dustinandrews/Red-Soul/readme

Robotic Minion Starter Kit (Arduino Compatible)
http://authenticinvention.com/authentic/?post_type=landing_page&p=47

Codename: Red-Soul

License: http://creativecommons.org/licenses/by/3.0/

Eagle files, code and other files for an Arduino compatible platform.
