dustinandrews/Red-Soul/Platform/OpenScad/pj-019.stl

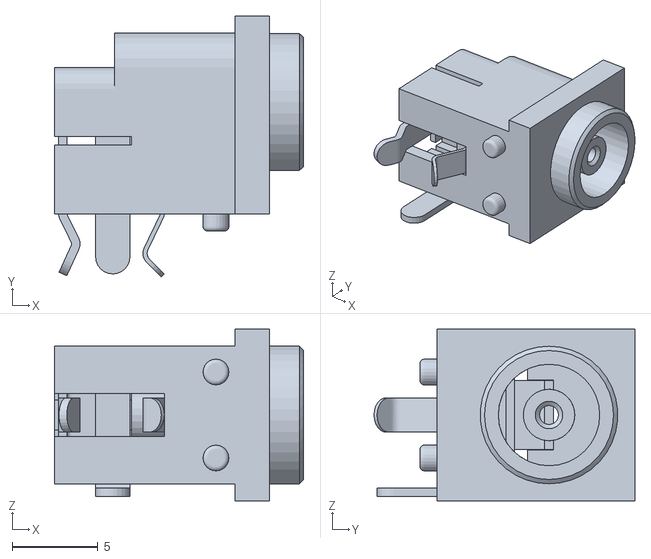
[picture p1: CAD file, 2012-04-17]
Platform/OpenScad/pj-019.stl
14.5 x 15.2 x 10.0
