dustinandrews/Red-Soul/Platform/OpenScad/SurfaceSwitch.stl

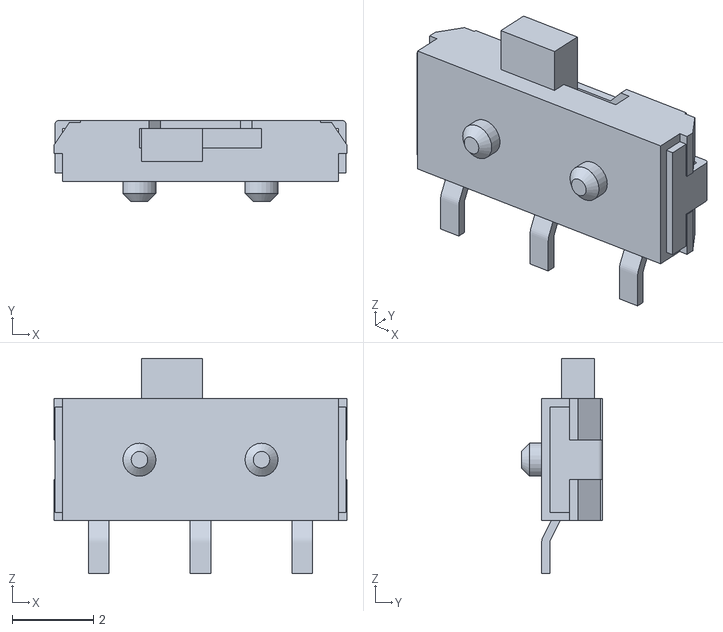
[picture p2: CAD file, 2012-04-17]
Platform/OpenScad/SurfaceSwitch.stl
7.20 x 2.00 x 5.29
