dustinandrews/Red-Soul/Platform/OpenScad/usbJack_B.stl

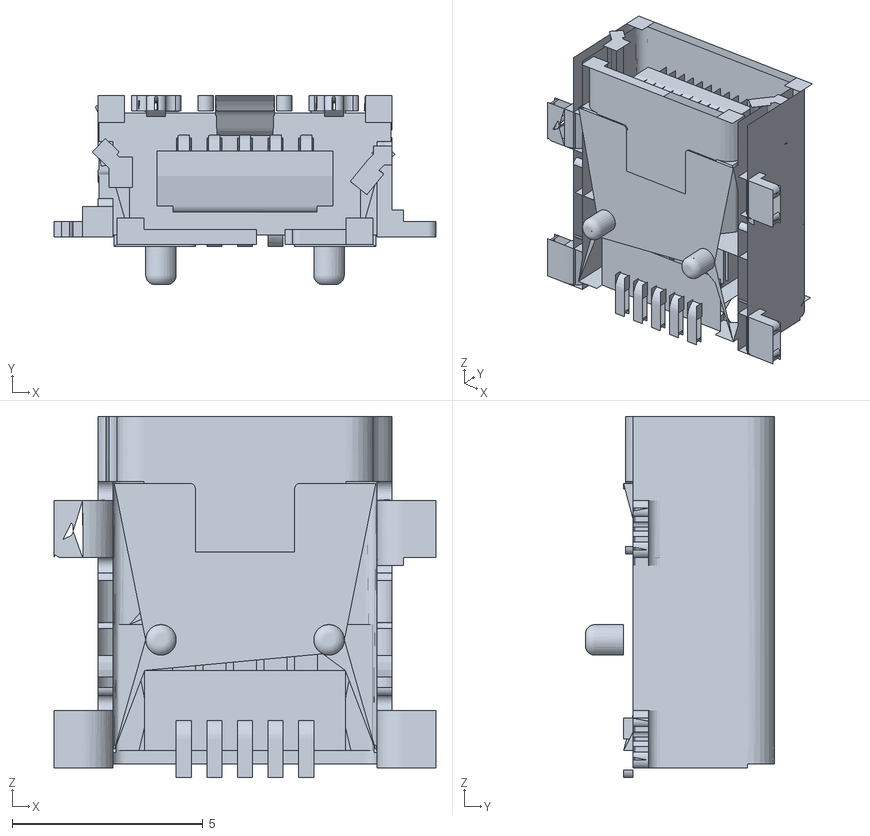
[picture p3: CAD file, 2012-04-17]
Platform/OpenScad/usbJack_B.stl
10.0 x 4.96 x 9.46
