dustinandrews/Red-Soul/Platform/PlatformCB.pdf

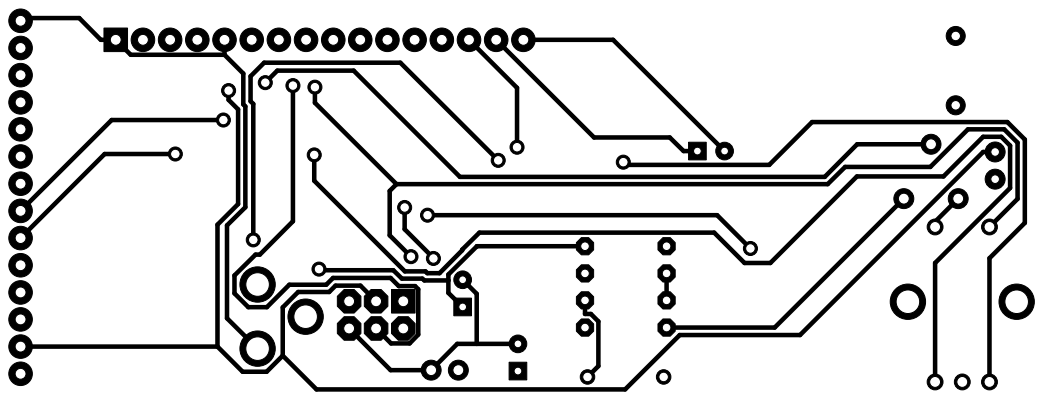
[picture p4: page 1]
