dustinandrews/Red-Soul/Platform/PlatformCT.pdf

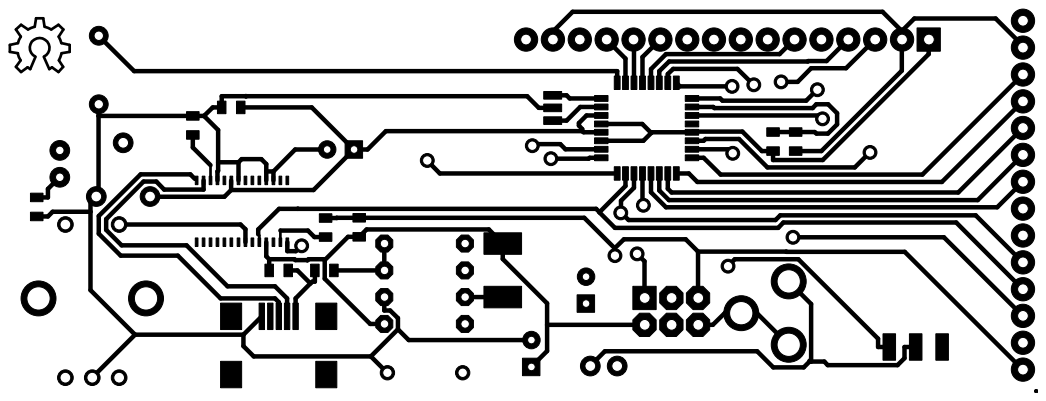
[picture p5: page 1]
