dustinandrews/Red-Soul/(list of files, drawings)

Other design files:
BuckRegulatorBoard/BuckPower.dsn
FTDI/ftdiBreakout.dsn
Platform/Platform.dsn
