dustinandrews/Red-Soul/Platform/Platform.brd

## EAGLE design Platform/Platform.brd (2012-07-20)

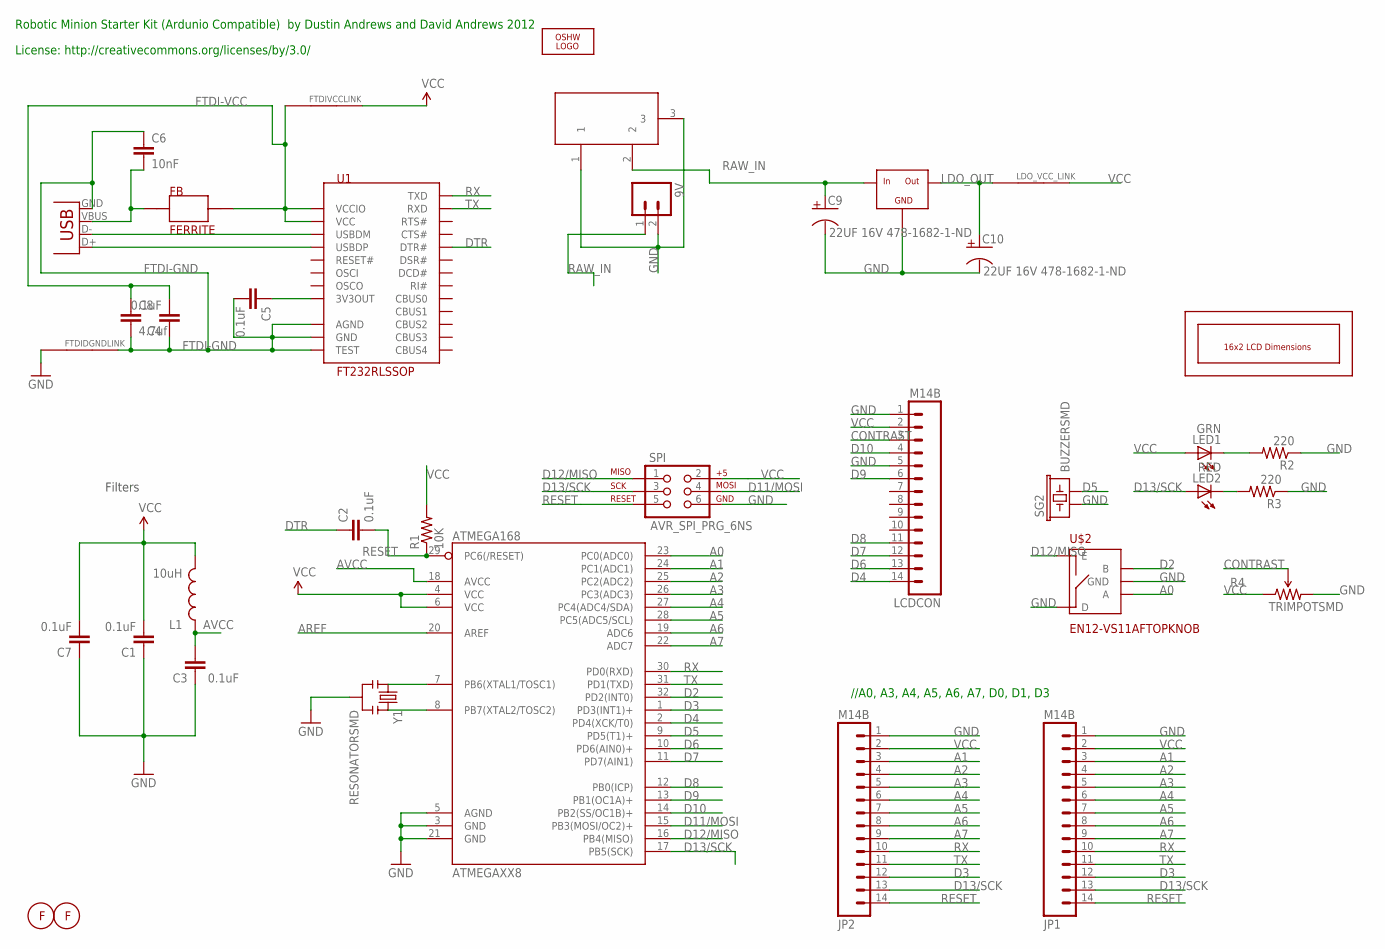
[picture p6: schematic Platform.sch]

Parts:
9V: M02PTH; 1X02
ATMEGAXX8: ATMEGA168; TQFP32-08; DIGIKEY# ATMEGA328-AU
C1, C2, C3, C4, C5, C7: 0.1uF; 0805; DIGIKEY# 478-1395-1-ND
C6: 10nF; C0805
C8: 4.7uf; 0805; DIGIKEY# 445-1369-1-ND
C9, C10: 22UF 16V 478-1682-1-ND; 1210POL; DIGIKEY# 478-1682-1-ND
FB: FERRITE; 0805; DIGIKEY# 240-2399-1-ND
FM1, FM2: FIDUCIAL1MM; 1MMCIRCLE
FTDIDGNDLINK: LINK; ISOLATOR
FTDIVCCLINK: LINK; ISOLATOR
J1: DC21MMX; DC-21MM
JP1, JP2: M14B; 1X14B
L1: 10uH; 0805; DIGIKEY# 587-2048-1-ND
LCDCON: M14B; 1X14B; DIGIKEY# 67-1781-ND
LDO_VCC_LINK: LINK; ISOLATOR
LED1: GRN; LED-0805; DIGIKEY# 754-1131-1-ND
LED2: RED; LED-0805; DIGIKEY# 475-1278-1-ND
LOGO1: OSHW_LOGO_10MILX0750-NT; OSHW_10X750_NOTEXT
R1: 10K; 0805; DIGIKEY# RHM10.0KAECT-ND
R2, R3: 220; 0805; DIGIKEY# RHM220AECT-ND
R4: TRIMPOTSMD; TRIMPOT-3MM; DIGIKEY# 490-4611-1-ND
SG2: BUZZERSMD; BUZZER-CMT1603; DIGIKEY# 668-1110-1-ND
SPI: AVR_SPI_PRG_6NS; 2X3-NS
U1: FT232RLSSOP; SSOP28; DIGIKEY# 768-1007-1-ND
U$1: IFX25001TC; TO263-3; DIGIKEY# IFX25001TC V50INCT-ND
U$2: EN12-VS11AFTOPKNOB; 12MM_ROTATY_TOP; DIGIKEY# 987-1194-ND
U$3: LCM-S01602DTR; LCD16X2
X1: USBSMD; USB-MINIB; DIGIKEY# ED2992CT-ND
Y1: RESONATORSMD; RESONATOR-SMD; DIGIKEY# 490-1198-1-ND

Connections:
3V3OUT: C5.1, U1.17 (3V3OUT)
A0: ATMEGAXX8.23 (PC0(ADC0)), U$2.A
A1: ATMEGAXX8.24 (PC1(ADC1)), JP1.3, JP2.3
A2: ATMEGAXX8.25 (PC2(ADC2)), JP1.4, JP2.4
A3: ATMEGAXX8.26 (PC3(ADC3)), JP1.5, JP2.5
A4: ATMEGAXX8.27 (PC4(ADC4/SDA)), JP1.6, JP2.6
A5: ATMEGAXX8.28 (PC5(ADC5/SCL)), JP1.7, JP2.7
A6: ATMEGAXX8.19 (ADC6), JP1.8, JP2.8
A7: ATMEGAXX8.22 (ADC7), JP1.9, JP2.9
AREF: ATMEGAXX8.20 (AREF)
AVCC: ATMEGAXX8.18 (AVCC), C3.2, L1.1
CONTRAST: LCDCON.3, R4.2 (WIPER)
D2: ATMEGAXX8.32 (PD2(INT0)), U$2.B
D3: ATMEGAXX8.1 (PD3(INT1)+), JP1.12, JP2.12
D4: ATMEGAXX8.2 (PD4(XCK/T0)), LCDCON.14
D5: ATMEGAXX8.9 (PD5(T1)+), SG2.P$2 (2)
D6: ATMEGAXX8.10 (PD6(AIN0)+), LCDCON.13
D7: ATMEGAXX8.11 (PD7(AIN1)), LCDCON.12
D8: ATMEGAXX8.12 (PB0(ICP)), LCDCON.11
D9: ATMEGAXX8.13 (PB1(OC1A)+), LCDCON.6
D10: ATMEGAXX8.14 (PB2(SS/OC1B)+), LCDCON.4
D11/MOSI: ATMEGAXX8.15 (PB3(MOSI/OC2)+), SPI.4
D12/MISO: ATMEGAXX8.16 (PB4(MISO)), SPI.1, U$2.E
D13/SCK: ATMEGAXX8.17 (PB5(SCK)), JP1.13, JP2.13, LED2.A, SPI.3
D+: U1.15 (USBDP), X1.D+
D-: U1.16 (USBDM), X1.D-
DTR: C2.1, U1.2 (DTR#)
FTDI-GND: C4.1, C5.2, C6.1, C8.2, FTDIDGNDLINK.P$2, U1.7 (GND), U1.18 (GND), U1.21 (GND), U1.25 (AGND), U1.26 (TEST), X1.GND
FTDI-VCC: C4.2, C8.1, FB.2, FTDIVCCLINK.P$1, U1.4 (VCCIO), U1.20 (VCC)
GND: 9V.2, ATMEGAXX8.3 (GND), ATMEGAXX8.5 (AGND), ATMEGAXX8.21 (GND), C1.1, C3.1, C7.1, C9.2 (-), C10.2 (-), FTDIDGNDLINK.P$1, J1.1, J1.3, JP1.1, JP2.1, LCDCON.1, LCDCON.5, R2.1, R3.1, R4.3 (CW), SG2.P$1 (1), SPI.6, U$1.2 (GND), U$1.TAB (GND), U$2.C (GND), U$2.D, Y1.2
LDO_OUT: C10.1 (+), LDO_VCC_LINK.P$1, U$1.3 (OUT)
unnamed: LED2.C, R3.2
unnamed: LED1.C, R2.2
RAW_IN: 9V.1, C9.1 (+), J1.2, U$1.1 (IN)
RESET: ATMEGAXX8.29 (PC6(/RESET)), C2.2, JP1.14, JP2.14, R1.1, SPI.5
RX: ATMEGAXX8.30 (PD0(RXD)), JP1.10, JP2.10, U1.1 (TXD)
TX: ATMEGAXX8.31 (PD1(TXD)), JP1.11, JP2.11, U1.5 (RXD)
VBUS: C6.2, FB.1, X1.VBUS
VCC: ATMEGAXX8.4 (VCC), ATMEGAXX8.6 (VCC), C1.2, C7.2, FTDIVCCLINK.P$2, JP1.2, JP2.2, L1.2, LCDCON.2, LDO_VCC_LINK.P$2, LED1.A, R1.2, R4.1 (CCW), SPI.2
XTAL1: ATMEGAXX8.7 (PB6(XTAL1/TOSC1)), Y1.1
XTAL2: ATMEGAXX8.8 (PB7(XTAL2/TOSC2)), Y1.3

Notes on the sheet:
Filters
//A0, A3, A4, A5, A6, A7, D0, D1, D3
Robotic Minion Starter Kit (Ardunio Compatible) by Dustin Andrews and David Andrews 2012
License: http://creativecommons.org/licenses/by/3.0/

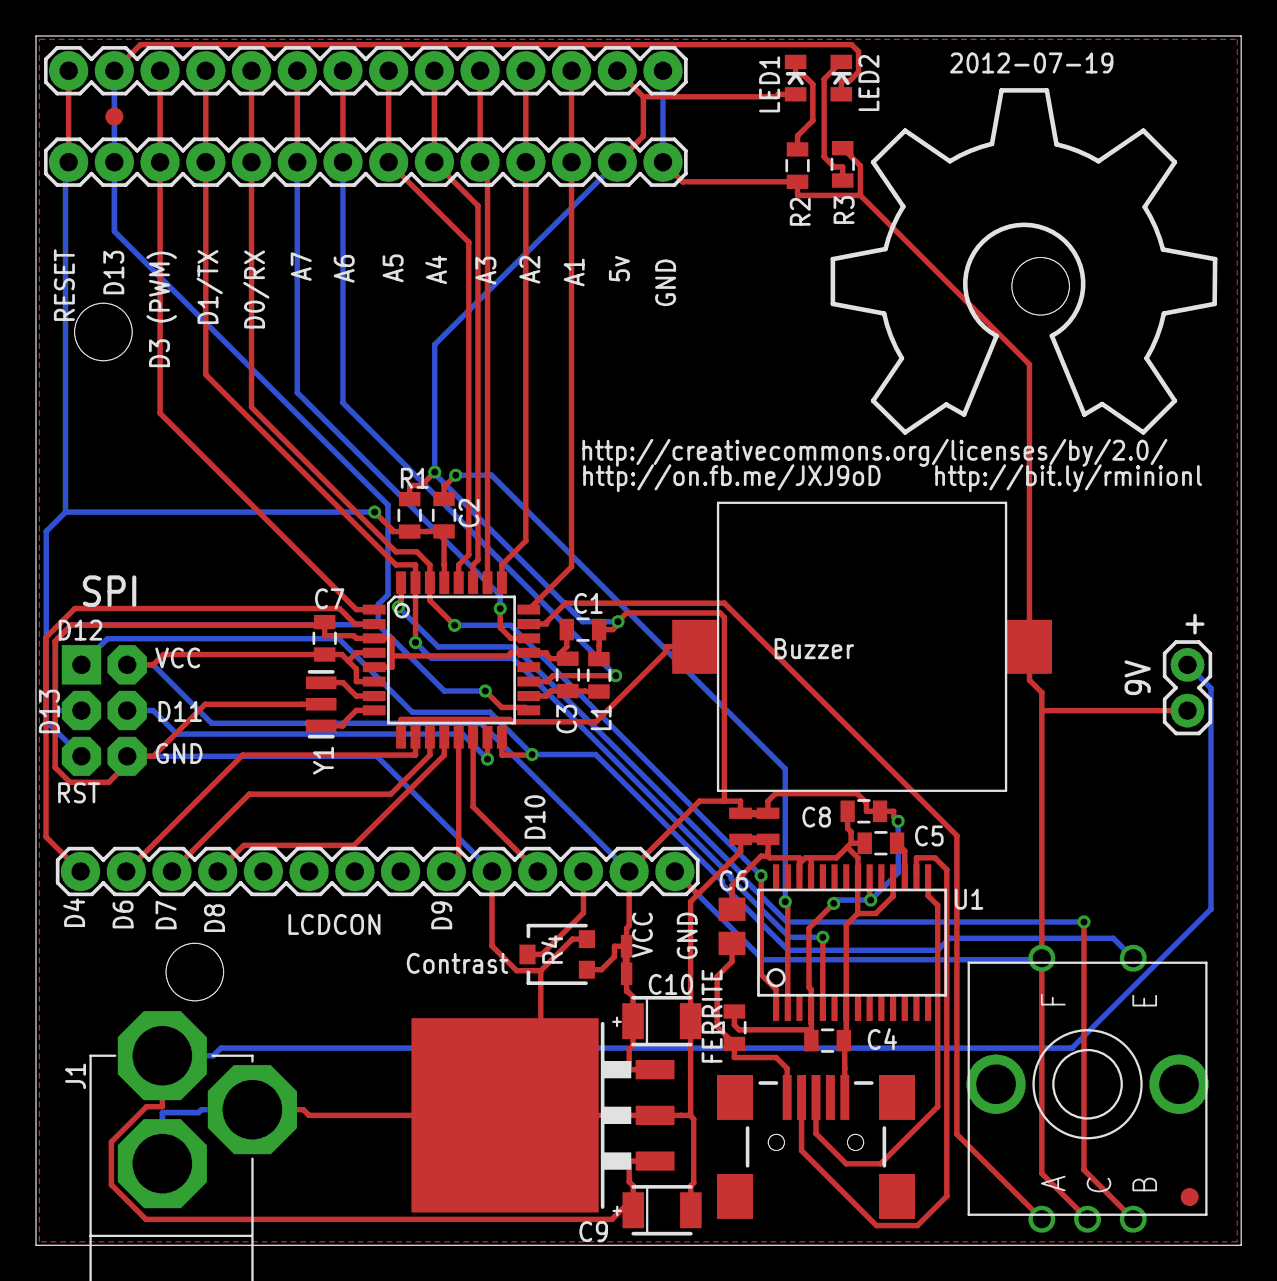
[picture p7: board Platform.brd from above]

Board: 2 copper layers, 67.0 x 67.2 mm, 38 parts (0 on the bottom side), 40 nets.
