dustinandrews/Red-Soul/BuckRegulatorBoard/BuckPower.brd

## EAGLE design BuckRegulatorBoard/BuckPower.brd (2012-04-22)

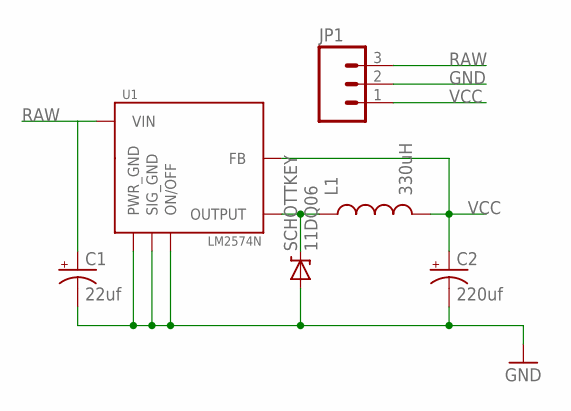
[picture p8: schematic BuckPower.sch]

Parts:
C1: 22uf; CPOL-RADIAL-100UF-25V
C2: 220uf; CPOL-RADIAL-100UF-25V
JP1: M031X03_NO_SILK; 1X03_NO_SILK
L1: 330uH; INDUCTOR-1206
SCHOTTKEY: 11DQ06; DIODE-ZENER
U1: LM2574N; 8DILL

Connections:
GND: C1.2 (-), C2.2 (-), JP1.2, SCHOTTKEY.P$2 (A), U1.2 (SIG_GND), U1.3 (ON/OFF), U1.4 (PWR_GND)
unnamed: L1.P$1 (1), SCHOTTKEY.P$1 (C), U1.7 (OUTPUT)
RAW: C1.1 (+), JP1.3, U1.5 (VIN)
VCC: C2.1 (+), JP1.1, L1.P$2 (2), U1.1 (FB)

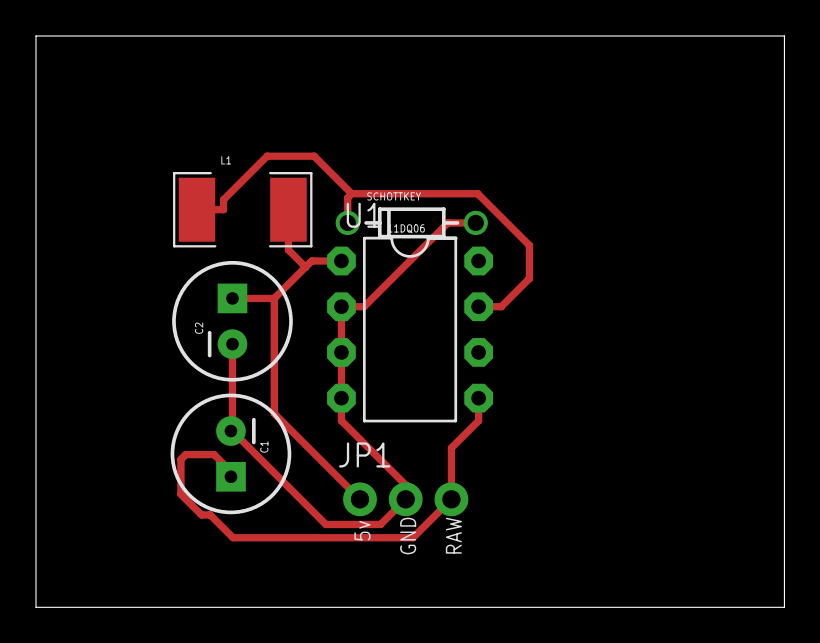
[picture p9: board BuckPower.brd from above]

Board: 2 copper layers, 41.6 x 31.7 mm, 6 parts (0 on the bottom side), 4 nets.
