dustinandrews/Red-Soul/FTDI/ftdiBreakout.brd

## EAGLE design FTDI/ftdiBreakout.brd (2012-04-22)

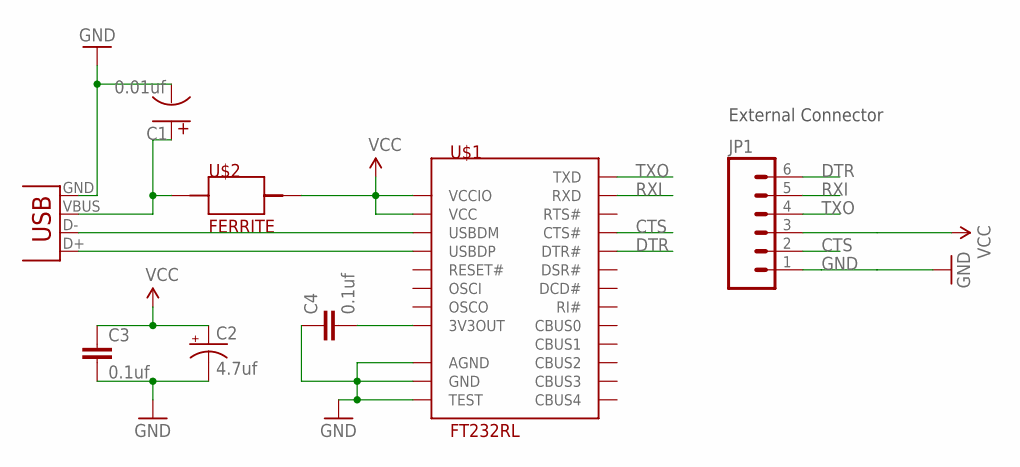
[picture p10: schematic ftdiBreakout.sch]

Parts:
C1: 0.01uf; 0805POL
C2: 4.7uf; CPOL-RADIAL-100UF-25V
C3, C4: 0.1uf; 0805
JP1: M06SIP; 1X06
U$1: FT232RL; TSSOP28
U$2: FERRITE; 0805
X1: USBSMD; USB-MINIB

Connections:
CTS: JP1.2, U$1.11 (CTS#)
DTR: JP1.6, U$1.2 (DTR#)
GND: C1.-, C2.2 (-), C3.2, C4.1, JP1.1, U$1.7 (GND), U$1.18 (GND), U$1.21 (GND), U$1.25 (AGND), U$1.26 (TEST), X1.GND
unnamed: C1.+, U$2.1, X1.VBUS
unnamed: U$1.16 (USBDM), X1.D-
unnamed: U$1.15 (USBDP), X1.D+
unnamed: C4.2, U$1.17 (3V3OUT)
RXI: JP1.5, U$1.5 (RXD)
TXO: JP1.4, U$1.1 (TXD)
VCC: C2.1 (+), C3.1, JP1.3, U$1.4 (VCCIO), U$1.20 (VCC), U$2.2

Notes on the sheet:
External Connector

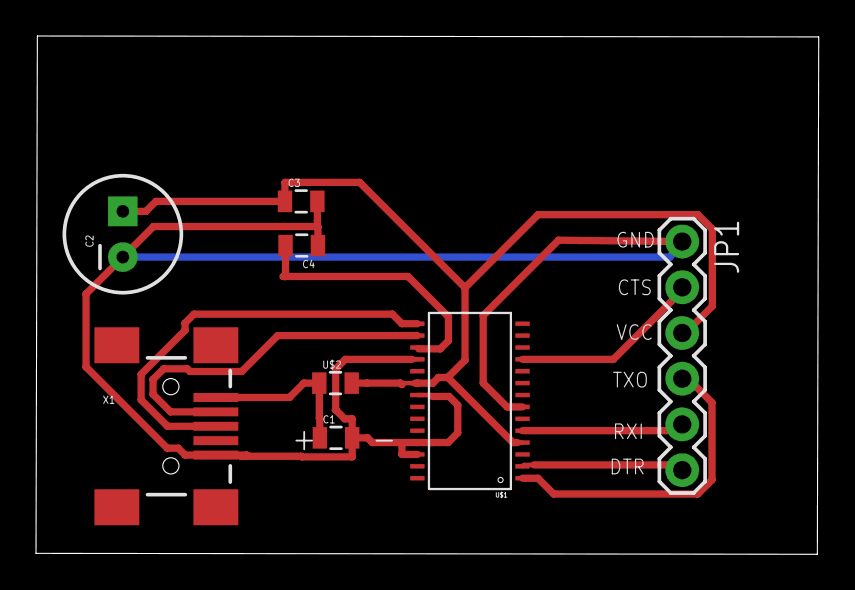
[picture p11: board ftdiBreakout.brd from above]

Board: 2 copper layers, 43.5 x 28.8 mm, 8 parts (0 on the bottom side), 10 nets.
