dustinandrews/Red-Soul/(commit log)

2012-04-11 fixed up design rules. Copied the actual newest boards into t the project
    [BuckPower.brd, Platform.brd, Platform.sch, ftdiBreakout.brd]
2012-04-13 added barrel connector and touched up top silk
    [Platform.brd, Platform.dsn, Platform.sch, ftdiBreakout.brd, ftdiBreakout.sch]
2012-04-16 updated component locations and traces
    [Platform.brd, Platform.sch]
2012-04-17 More board tweak, added part list and toner file used to make pre prototype 2
    [Platform.brd, Platform.dsn, Platform.sch, RedSoulPartsList.csv]
2012-04-17 Cad files added
    [SurfaceSwitch.stl, ninevolt.scad, pj-019.stl, redsoulRender.scad, usbJack_B.stl]
2012-04-22 Tested versions of breakout boards
    [BuckPower.brd, BuckPower.dsn, BuckPower.sch, ftdiBreakout.brd, ftdiBreakout.dsn, ftdiBreakout.sch]
2012-04-22 added breakout boards parts lists
    [FTDIPartsList.csv, RegulatorPartsList.csv]
2012-05-02 prototype 3
    [Platform.brd, Platform.dsn, Platform.sch, redsoulRender.scad]
2012-05-03 Fixed some issues with the FTDI. Created Gerbers. Sent version off for manufacture.
    [Platform.brd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]
2012-05-13 updates from prototype 3
    [Platform.brd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]
2012-05-13 updated parts list
    [RedSoulPartsList.csv]
2012-05-15 prototype 4
    [Platform.brd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]
2012-05-22 Fixed typo and terminal spacing.
    [Platform.brd]
2012-05-22 Updated Gerbers
    [Platform.GBL, Platform.GBO, Platform.GBS, Platform.GTL, Platform.GTO, Platform.GTP, Platform.GTS]
2012-05-22 fixed error in parts list
    [RedSoulPartsList.csv]
2012-06-05 switched back to LDO
    [Platform.brd, Platform.sch]
2012-06-06 wiring traces added
    [Platform.brd, Platform.dsn, Platform.sch]
2012-06-06 Added DIGIKEY# attribute to parts and generated BOM
    [MinionPartsList.csv, Platform.brd, Platform.sch]
2012-06-08 added dimensions, reference drawing for lcd
    [MinionPartsList.csv, Platform.brd, Platform.dsn, Platform.sch]
2012-06-14 Prototype 5 changes
    [Platform.brd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]
2012-07-08 Added enclosure drawing
2012-07-08 Really added drawing of enclosure and updated the silk screen on the board.
    [Platform.brd]
2012-07-20 Better filter placement and moved 9v terminal to a better spot
    [Platform.brd, Platform.sch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]
2012-07-24 Latest tweaks to enclosure
