dustinandrews/Red-Soul/(notices)

Notices in the files:
Platform/Platform.brd:
http://creativecommons.org/licenses/by/2.0
parts and their libraries:
SparkFun: Licensing: CC v3.0 Share-Alike You are welcome to use this library for commercial purposes.
